cburgess5294/Arduino-Teensy4/v1.0/Arduino-Teensy4_PLUS_ESP-12E_r1-SCH.pdf

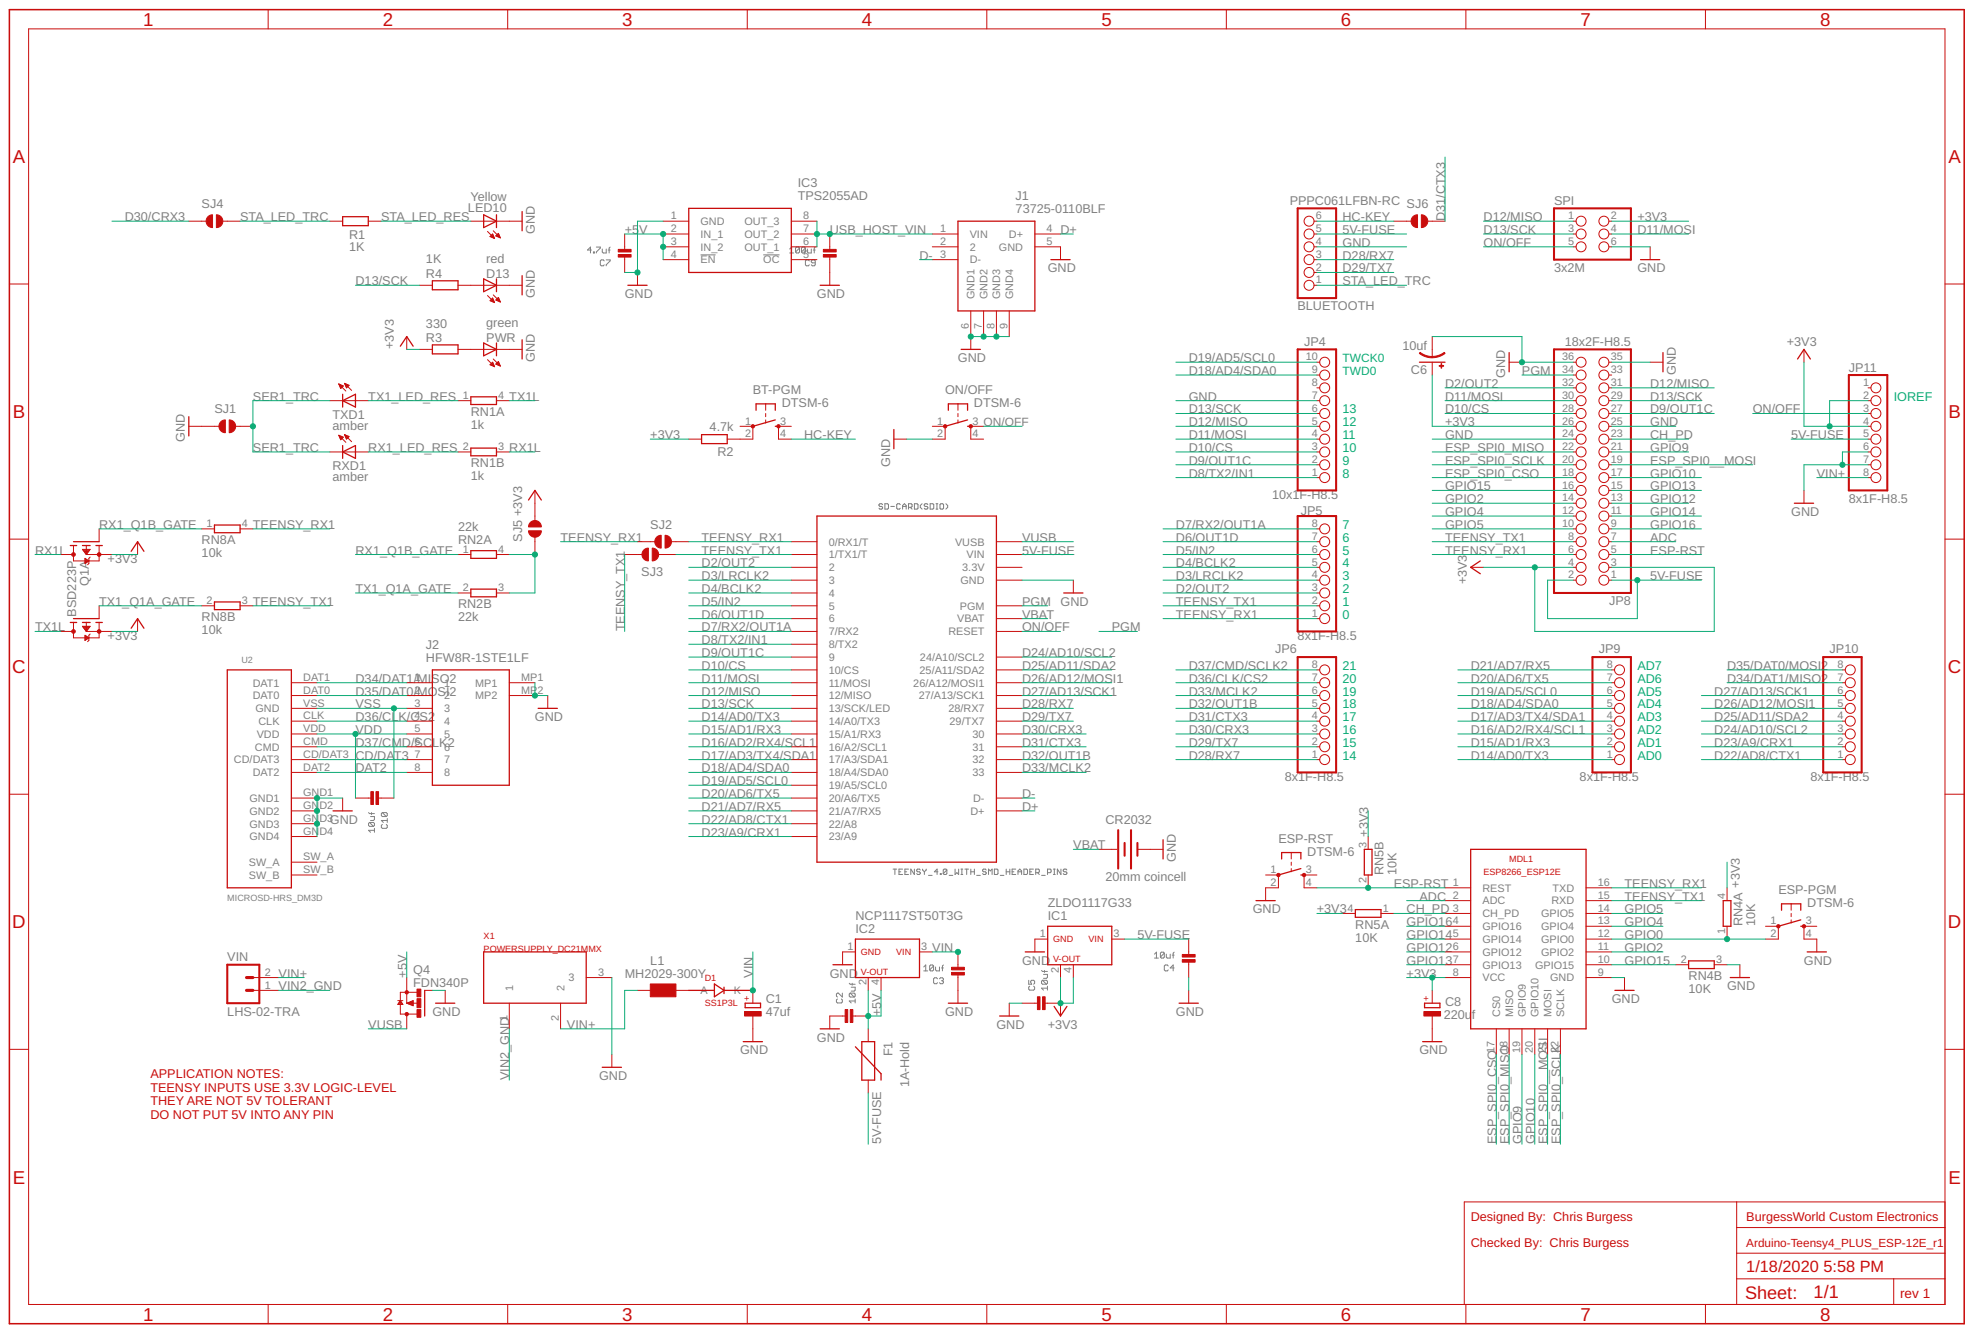
[picture p1: page 1]

APPLICATION NOTES:
TEENSY INPUTS USE 3.3V LOGIC-LEVEL
THEY ARE NOT 5V TOLERANT
DO NOT PUT 5V INTO ANY PIN

Checked By: Chris Burgess
