cburgess5294/Arduino-Teensy4/v1.0/Arduino-Teensy4_PLUS_ESP-12E_r1-BRD.pdf

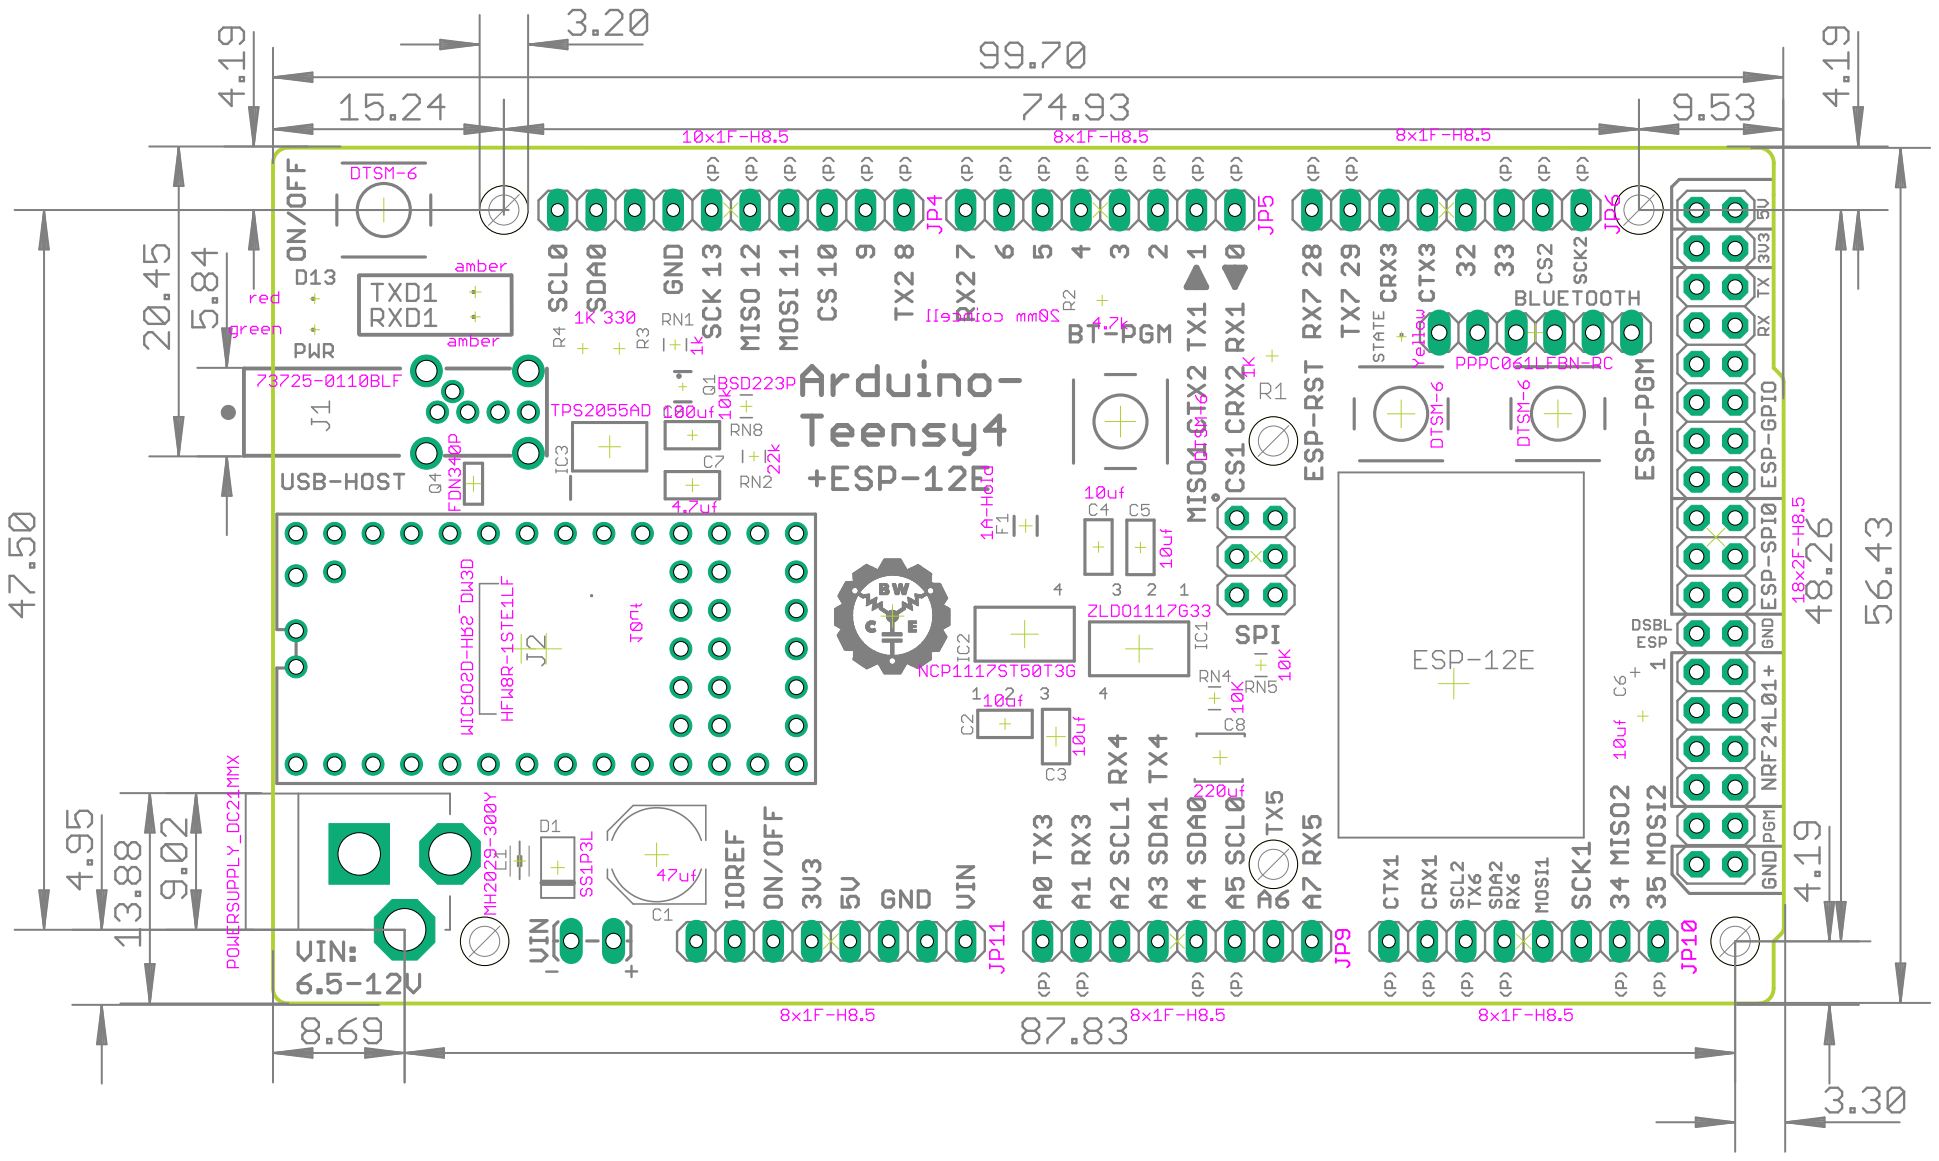
[picture p2: page 1]
